sergeyyarkov/attiny45v_thermometer/hardware/hardware.pdf

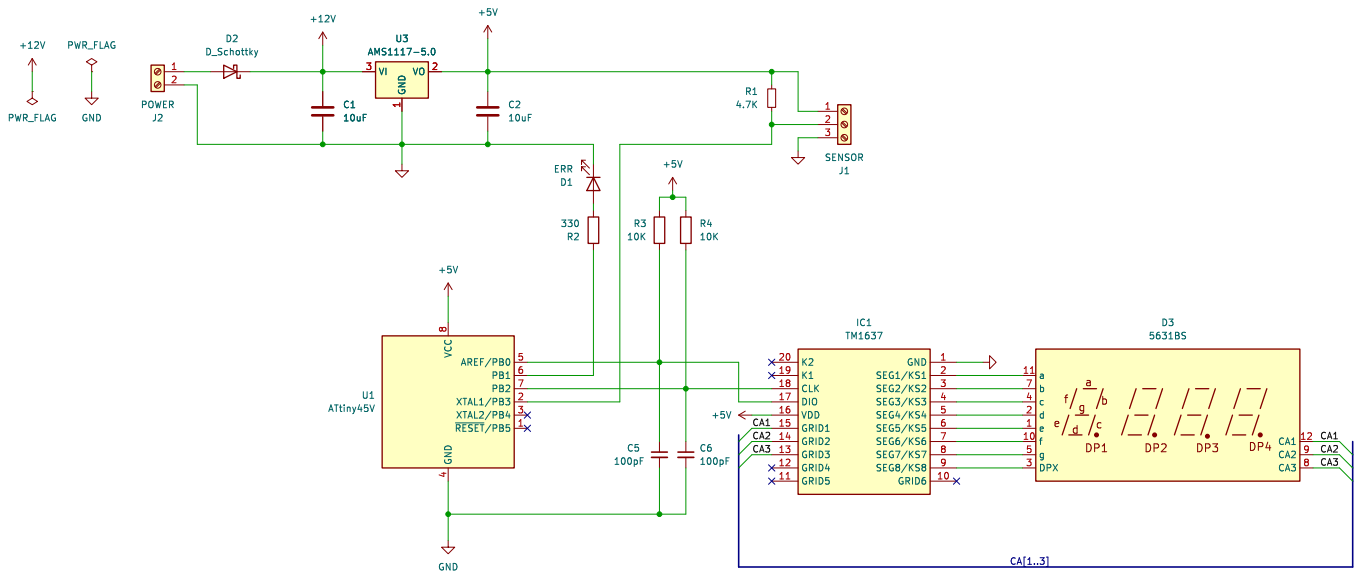
[picture p1: page 1]
