sergeyyarkov/attiny45v_thermometer/(list of files, drawings)

Other design files:
proteus/attiny45v_thermometer.pdsprj
