sergeyyarkov/attiny45v_thermometer/hardware/hardware/hardware.kicad_pcb

## KiCad design hardware/hardware/hardware.kicad_pcb (2023-08-18)

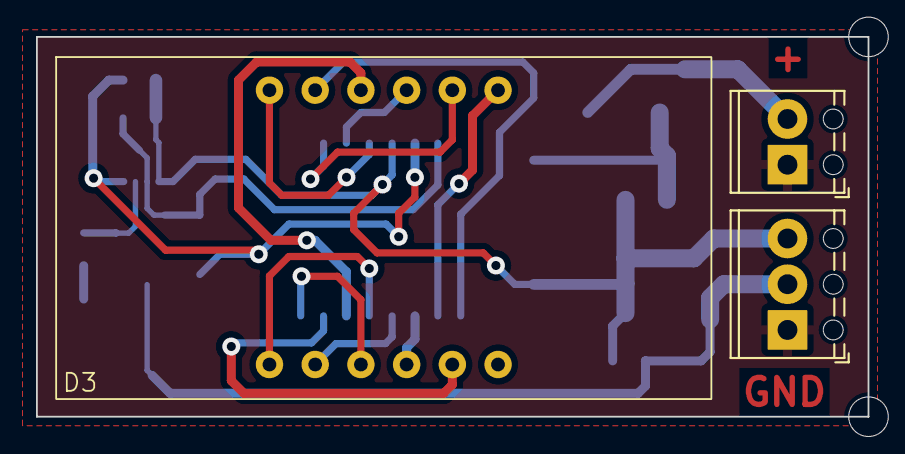
[picture p2: board hardware.kicad_pcb from above]

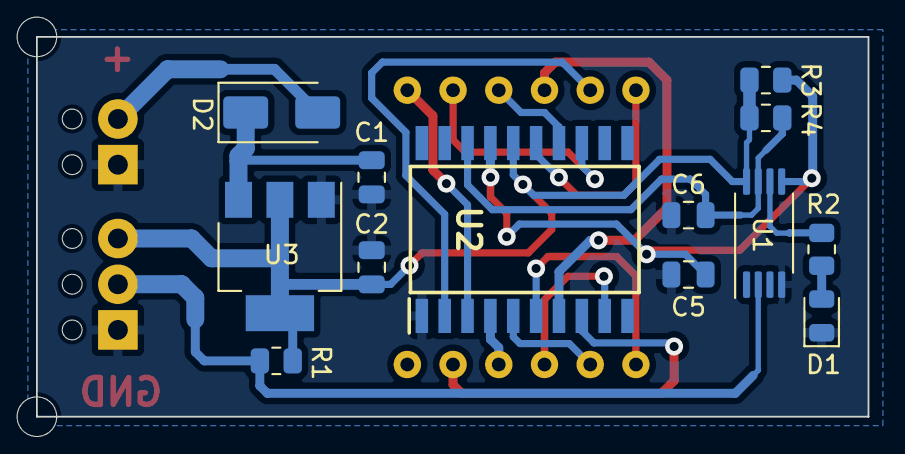
[picture p3: board hardware.kicad_pcb from below]

Board: 2 copper layers, 46.2 x 21.1 mm, 16 parts (13 on the bottom side), 20 nets.

Parts:
C1, C2: 10uF; C_0805_2012Metric
C5, C6: 100pF; C_0805_2012Metric
D1: ERR; LED_0805_2012Metric
D2: D_Schottky; D_SMA
D3: 5631BS
J1: SENSOR; TerminalBlock_Phoenix_MPT-0,5-3-2.54_1x03_P2.54mm_Horizontal
J2: POWER; TerminalBlock_Phoenix_MPT-0,5-2-2.54_1x02_P2.54mm_Horizontal
R1: 4.7K; R_0805_2012Metric
R2: 330; R_0805_2012Metric
R3, R4: 10K; R_0805_2012Metric
U1: ATtiny45V; TSSOP-8_4.4x3mm_P0.65mm
U2: TM1637; SOIC127P1045X280-20N
U3: AMS1117-5.0; SOT-223-3_TabPin2

Connections:
+5V: C2.1, J1.3, R1.2, R3.1, R4.1, U1.8 (VCC), U2.16 (VDD), U3.2 (VO)
+12V: C1.1, D2.1 (K), U3.3 (VI)
/CA1: D3.12 (CA1), U2.15 (GRID1)
/CA2: D3.9 (CA2), U2.14 (GRID2)
/CA3: D3.8 (CA3), U2.13 (GRID3)
GND: C1.2, C2.2, C5.2, C6.2, D1.1 (K), J1.1, J2.1, U1.4 (GND), U2.1 (GND), U3.1 (GND)
unnamed: D1.2 (A), R2.2
unnamed: D2.2 (A), J2.2
unnamed: D3.3 (DPX), U2.9 (SEG8/KS8)
unnamed: D3.11 (a), U2.2 (SEG1/KS1)
unnamed: D3.7 (b), U2.3 (SEG2/KS2)
unnamed: D3.4 (c), U2.4 (SEG3/KS3)
unnamed: D3.2 (d), U2.5 (SEG4/KS4)
unnamed: D3.1 (e), U2.6 (SEG5/KS5)
unnamed: D3.10 (f), U2.7 (SEG6/KS6)
unnamed: D3.5 (g), U2.8 (SEG7/KS7)
unnamed: J1.2, R1.1, U1.2 (XTAL1/PB3)
unnamed: C5.1, R3.2, U1.5 (AREF/PB0), U2.17 (DIO)
unnamed: R2.1, U1.6 (PB1)
unnamed: C6.1, R4.2, U1.7 (PB2), U2.18 (CLK)
