sergeyyarkov/attiny45v_thermometer/(commit log)

2023-07-08 read temperature
2023-08-06 hide zeros & small fix
    [main.c]
2023-08-06 watchdog timer
2023-08-06 folder structure
    [attiny45v_thermometer.pdsprj, hardware.kicad_pcb, hardware.kicad_sch]
